star-waroobah/Starbie/BOM.csv

Item | Qty | Supplier | Cost/item | Total Cost | link
XIAO ESP32 C3 | 1 | Seeed studio | $4.90 | $4.90 | https://www.seeedstudio.com/Seeed-XIAO-ESP32C3-p-5431.html
0.96 inch OLED display (12C) | 1 | Daraz | $2.53 | $2.53 | https://www.daraz.pk//products/i400396294-s1934234289.html?urlFlag=true
DHT11 | 1 | Daraz | $2.90 | $2.90 | https://tinyurl.com/9fm7tvjk
10k resistor (pack of 10) | 1 | Daraz | $0.42 | $0.42 | https://www.daraz.pk//products/i465392816-s2198965661.html?urlFlag=true
Custom PCB (starbie) | 1 | pcbx | $6.44 | $6.44 | https://www.pcbx.com/order/manufacturing/pcb
MPU6050 module | 1 | Daraz | $1.81 | $1.81 | https://tinyurl.com/fe83xnmz
MX Cherry push buttons | 1 | Daraz | $4.09 | $4.09 | https://tinyurl.com/4vrjbk5y
Estimated total shipping | 1 |  |  | $9.40
