star-waroobah/Starbie/(commit log)

2026-10-11 Add Starbie PCB files and gerbers
    [STARBIE W-B_Cu.gbr, STARBIE W-B_Mask.gbr, STARBIE W-B_Paste.gbr, STARBIE W-B_Silkscreen.gbr, STARBIE W-Edge_Cuts.gbr, STARBIE W-F_Cu.gbr, STARBIE W-F_Mask.gbr, STARBIE W-F_Paste.gbr]
2026-10-11 board pics throughout the process
2026-10-19 Sync Starbie from Half Life
    [BOM.csv]
2026-10-20 Update Gerbers after fixing some errors
    [STARBIE W-B_Cu.gbr, STARBIE W-B_Mask.gbr, STARBIE W-B_Silkscreen.gbr, STARBIE W-Edge_Cuts.gbr, STARBIE W-F_Cu.gbr, STARBIE W-F_Mask.gbr, STARBIE W-F_Silkscreen.gbr, STARBIE W-NPTH.drl]
2026-10-20 updated files after some resolved problems
    [STARBIE W.kicad_pcb, STARBIE W.kicad_sch]
2026-10-22 Organized repo into pcb and production folders
    [STARBIE W-B_Cu.gbr, STARBIE W-B_Mask.gbr, STARBIE W-B_Silkscreen.gbr, STARBIE W-Edge_Cuts.gbr, STARBIE W-F_Cu.gbr, STARBIE W-F_Mask.gbr, STARBIE W-F_Silkscreen.gbr, STARBIE W-NPTH.drl]
2026-10-22 Remove old gerbers folder
    [STARBIE W-B_Cu.gbr, STARBIE W-B_Mask.gbr, STARBIE W-B_Silkscreen.gbr, STARBIE W-Edge_Cuts.gbr, STARBIE W-F_Cu.gbr, STARBIE W-F_Mask.gbr, STARBIE W-F_Silkscreen.gbr, STARBIE W-NPTH.drl]
2026-10-22 Remove old loose file
    [STARBIE W.kicad_pcb]
2026-10-22 Add assets folder with new board screenshots
